VolodymyrSemenov/refresh-o-matic/images/robot_back.png

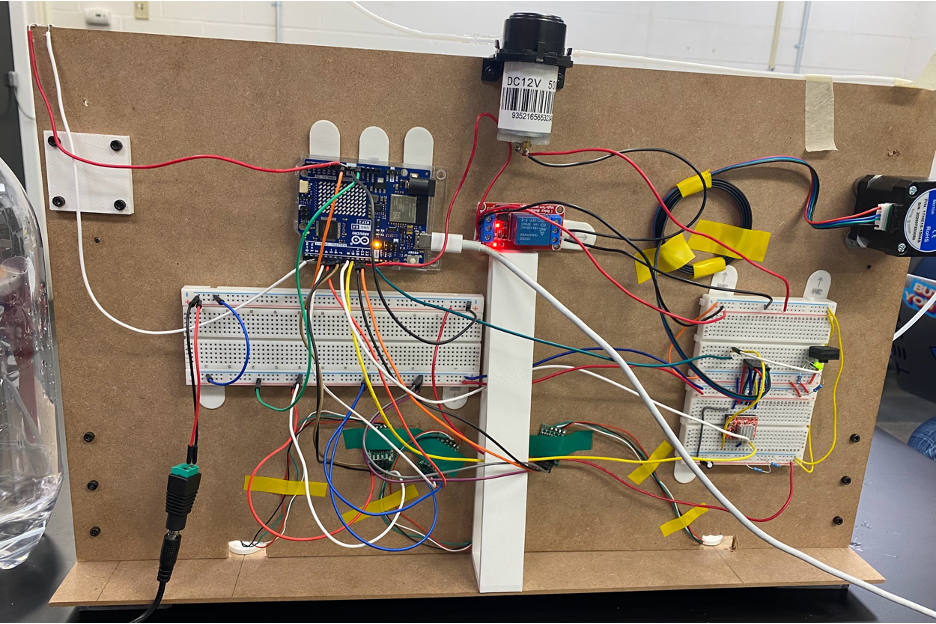
images/robot_back.png
