VolodymyrSemenov/refresh-o-matic/images/robot_front.png

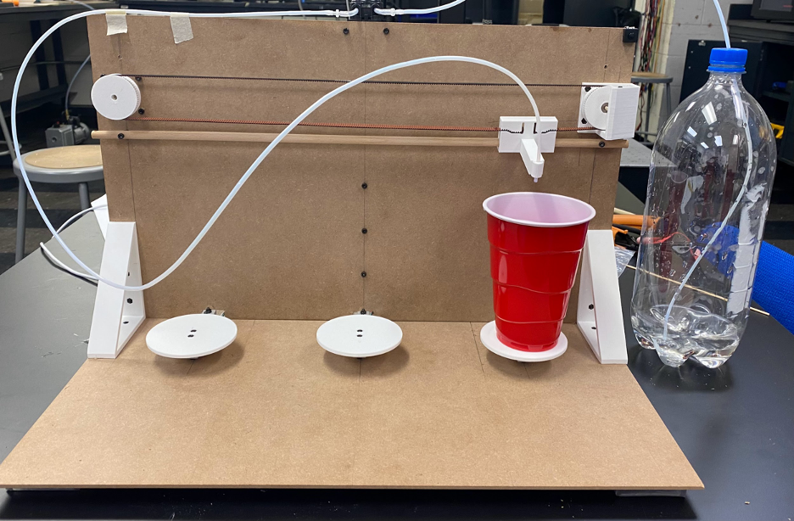
images/robot_front.png
