VolodymyrSemenov/refresh-o-matic/schematic.png

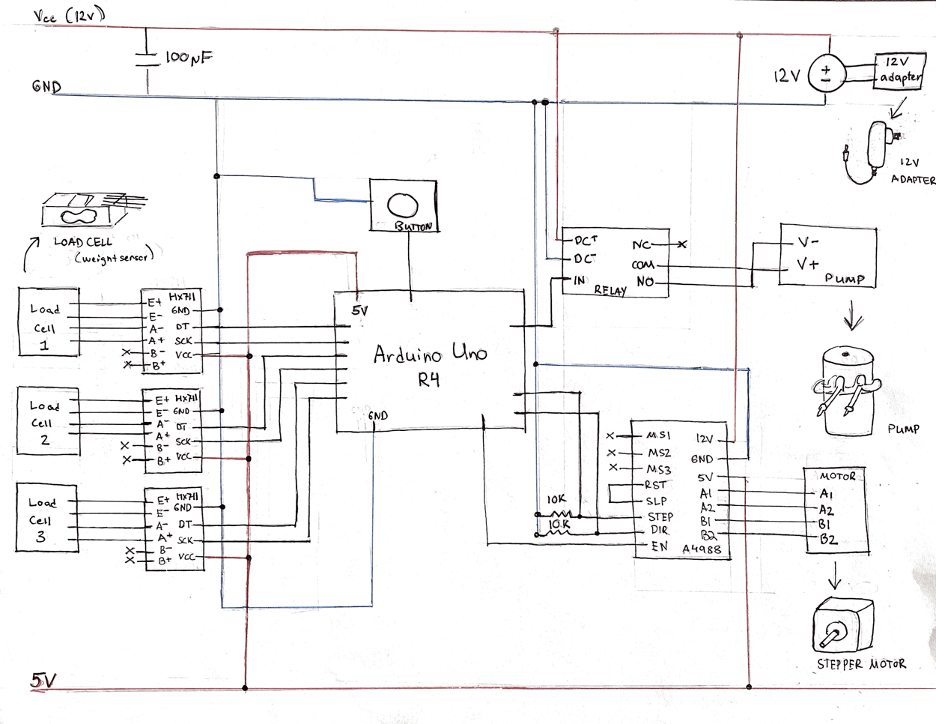
schematic.png
