VolodymyrSemenov/refresh-o-matic/software_flow_chart.png

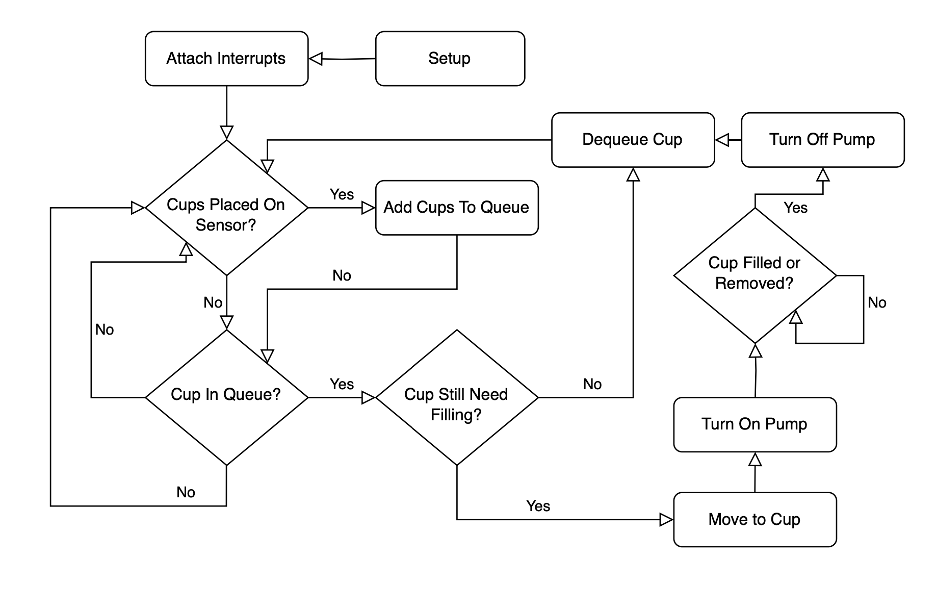
software_flow_chart.png
