VolodymyrSemenov/refresh-o-matic/Codebase/animation.h

const uint32_t animation[][4] = {
	{
		0x80,
		0x8008008,
		0x800000,
		66
	},
	{
		0x80040,
		0x4004004,
		0x400800,
		66
	},
	{
		0xc0020,
		0x2002002,
		0x200c00,
		66
	},
	{
		0xe0010,
		0x1001001,
		0x100e00,
		66
	},
	{
		0x70088,
		0x800800,
		0x80880700,
		66
	},
	{
		0x38044,
		0x400400,
		0x40440380,
		66
	},
	{
		0x1c0a2,
		0x200208,
		0x20a201c0,
		66
	},
	{
		0x8e051,
		0x108104,
		0x105108e0,
		66
	},
	{
		0xc7028,
		0x8008c082,
		0x8288c70,
		66
	},
	{
		0xe3814,
		0x4004e041,
		0x4144e38,
		66
	},
	{
		0x71c8a,
		0x28027020,
		0x828a271c,
		66
	},
	{
		0x38e45,
		0x14013810,
		0x4145138e,
		66
	},
	{
		0x9c7a2,
		0x8a009c08,
		0x20a289c7,
		66
	},
	{
		0xce351,
		0x4500ce04,
		0x10514ce3,
		66
	},
	{
		0xe7128,
		0xa280e702,
		0x828ae71,
		66
	},
	{
		0xf3814,
		0x5140f381,
		0x4145f38,
		66
	},
	{
		0xf9c0a,
		0x20a079c0,
		0x820a2f9c,
		66
	},
	{
		0x7ce05,
		0x10503ce0,
		0x410517ce,
		66
	},
	{
		0x3e782,
		0x80281e70,
		0x208283e7,
		66
	},
	{
		0x9f341,
		0x40140f30,
		0x104149f3,
		66
	},
	{
		0xcf920,
		0xa00a8790,
		0x820acf9,
		66
	},
	{
		0xe7c10,
		0x5005c3c0,
		0x4105e7c,
		66
	},
	{
		0x73e88,
		0x280261e8,
		0x288273e,
		66
	},
	{
		0x39f44,
		0x140130f4,
		0x144139f,
		66
	},
	{
		0x9cf22,
		0x2001872,
		0xa201cf,
		66
	},
	{
		0xce791,
		0x1000c31,
		0x5108e7,
		66
	},
	{
		0xe7348,
		0x88800610,
		0x80288c73,
		66
	},
	{
		0xf3924,
		0x44408300,
		0x40144e39,
		66
	},
	{
		0xf9c12,
		0x22204188,
		0x208a271c,
		66
	},
	{
		0x7ce09,
		0x111020c4,
		0x1045138e,
		66
	},
	{
		0xbe704,
		0x80881062,
		0x8a281c7,
		66
	},
	{
		0xdf382,
		0x48448839,
		0x4d148e3,
		66
	},
	{
		0xef941,
		0x24224414,
		0x8268a471,
		66
	},
	{
		0x77c20,
		0x92112202,
		0x41345238,
		66
	},
	{
		0x3be10,
		0x41089109,
		0x209a211c,
		66
	},
	{
		0x1df08,
		0x2884c88c,
		0x90cd188e,
		66
	},
	{
		0xef84,
		0x1c42e44e,
		0x48e68c47,
		66
	},
	{
		0x877c2,
		0xe21f22f,
		0x24f34623,
		66
	},
	{
		0xc3be1,
		0xf10f91f,
		0x92f9a311,
		66
	},
	{
		0x61df0,
		0x8f88fc8f,
		0xc9fcd988,
		66
	},
	{
		0x30e78,
		0x4fc4fe4f,
		0xe4fe6cc4,
		66
	},
	{
		0x1873c,
		0x27e2ff2f,
		0xf2ff3662,
		66
	},
	{
		0xc31e,
		0x13f17f97,
		0xf97f9331,
		66
	},
	{
		0x610f,
		0x1f83fc3,
		0xfc3fc198,
		66
	},
	{
		0x3007,
		0x80fc1fe1,
		0xfe1fe0cc,
		66
	},
	{
		0x1803,
		0xc07e0ff0,
		0xff0ff066,
		66
	},
	{
		0xc01,
		0xe03f07f0,
		0x7f07f033,
		66
	},
	{
		0x600,
		0xf01f03f0,
		0x3f03f019,
		66
	},
	{
		0x300,
		0x700f01f0,
		0x1f01f00c,
		66
	},
	{
		0x100,
		0x300700f0,
		0xf00f006,
		66
	},
	{
		0x0,
		0x10030070,
		0x7007003,
		66
	},
	{
		0x0,
		0x10030,
		0x3003001,
		66
	},
	{
		0x0,
		0x10,
		0x1001000,
		66
	},
	{
		0x0,
		0x0,
		0x0,
		66
	},
	{
		0x0,
		0x0,
		0x0,
		66
	},
	{
		0x0,
		0x0,
		0x0,
		66
	}
};
